bobkim938/auto-levelling-platform/README.md

# auto-levelling-platform using low cost IMU
