bobkim938/auto-levelling-platform/CAD/motor/FS5106R/Stiker.png

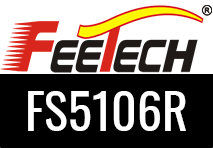
CAD/motor/FS5106R/Stiker.png
