bobkim938/auto-levelling-platform/CAD/Small Assem.SLDASM

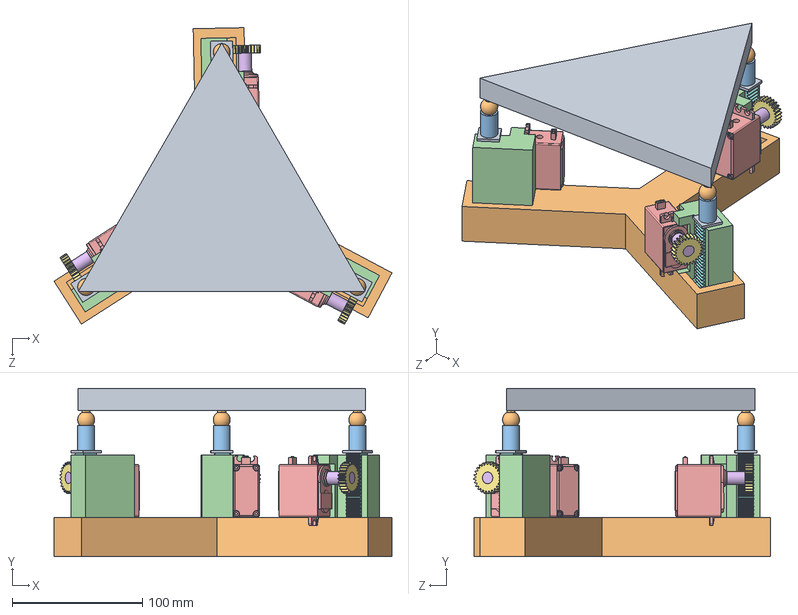
[picture p46: CAD file, 2023-07-06]
CAD/Small Assem.SLDASM
259.1 x 128.9 x 227.4 mm
END_EFFECTOR_Smaller
Linear guideFINAL x 3
FS5106R x 3
Motor_acc2 x 3
spur gear_iso x 3
rack spur rectangular_iso x 3
Top x 3
Base_small
