bobkim938/auto-levelling-platform/CAD/Actuator/2/Assem2.SLDASM

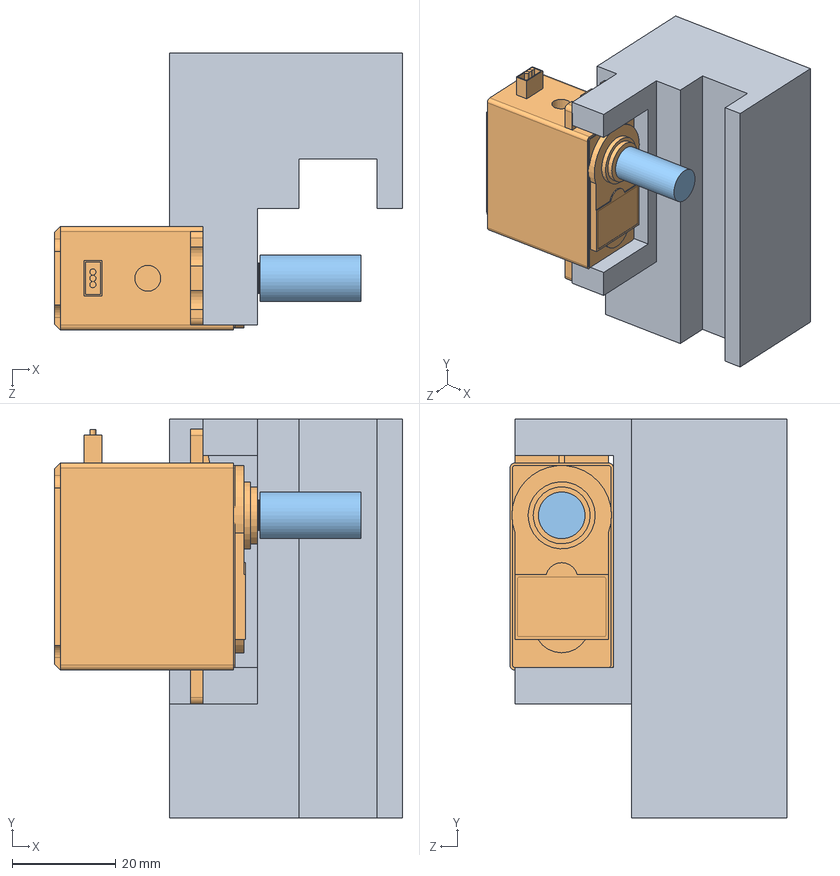
[picture p47: CAD file, 2023-07-06]
CAD/Actuator/2/Assem2.SLDASM
67.2 x 77.0 x 53.5 mm
Linear guide 2
FS5106R
Motor_acc2
