bobkim938/auto-levelling-platform/CAD/Spherical Joint/Ball and Socket Joint.SLDASM

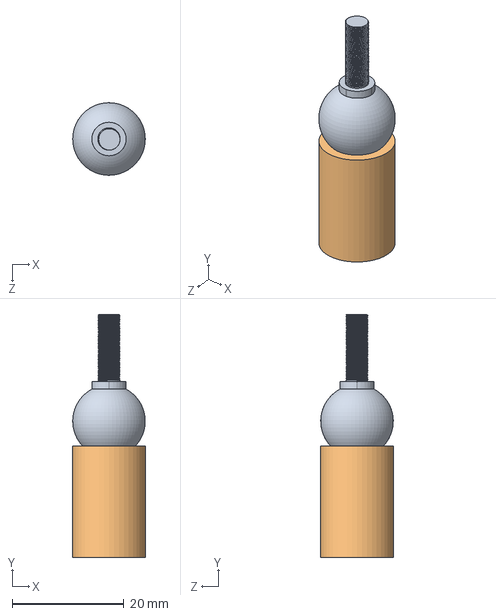
[picture p48: CAD file, 2023-07-06]
CAD/Spherical Joint/Ball and Socket Joint.SLDASM
13.0 x 43.5 x 13.0 mm
