bobkim938/auto-levelling-platform/CAD/Actuator/2/FinalAssembly.SLDASM

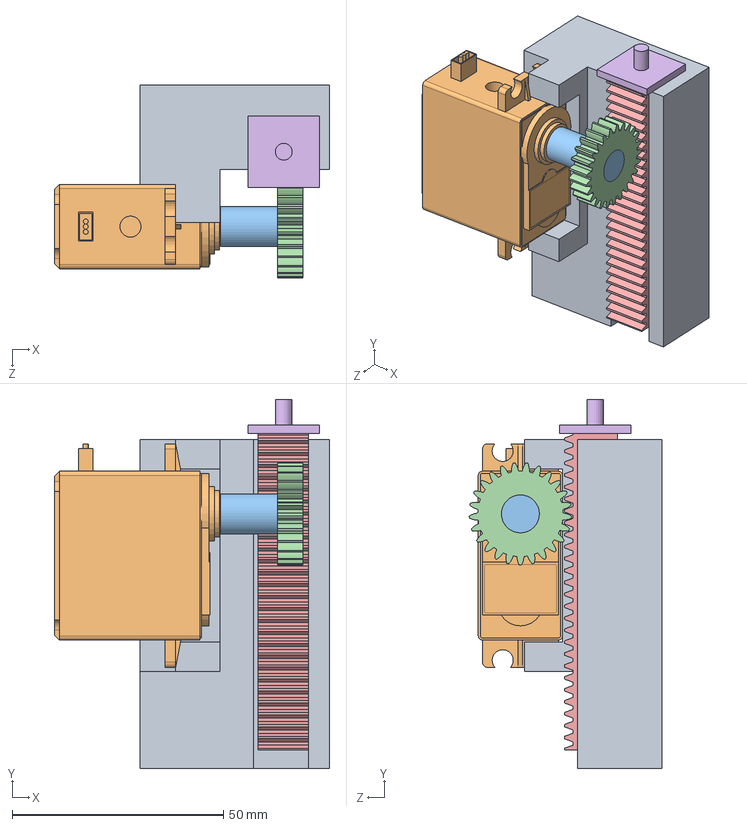
[picture p49: CAD file, 2023-07-06]
CAD/Actuator/2/FinalAssembly.SLDASM
65.2 x 87.4 x 45.6 mm
Linear guideFINAL
FS5106R
Motor_acc2
spur gear_iso
rack spur rectangular_iso
Top
