bobkim938/auto-levelling-platform/CAD/Actuator/2/Bottom.SLDPRT

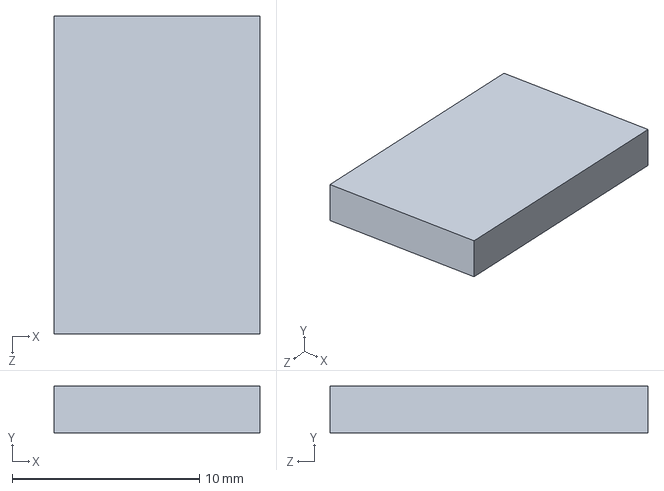
[picture p50: CAD file, 2023-07-06]
CAD/Actuator/2/Bottom.SLDPRT
11.0 x 2.50 x 17.0 mm
