bobkim938/auto-levelling-platform/CAD/Actuator/stl/2/Linear guideFINAL.SLDPRT

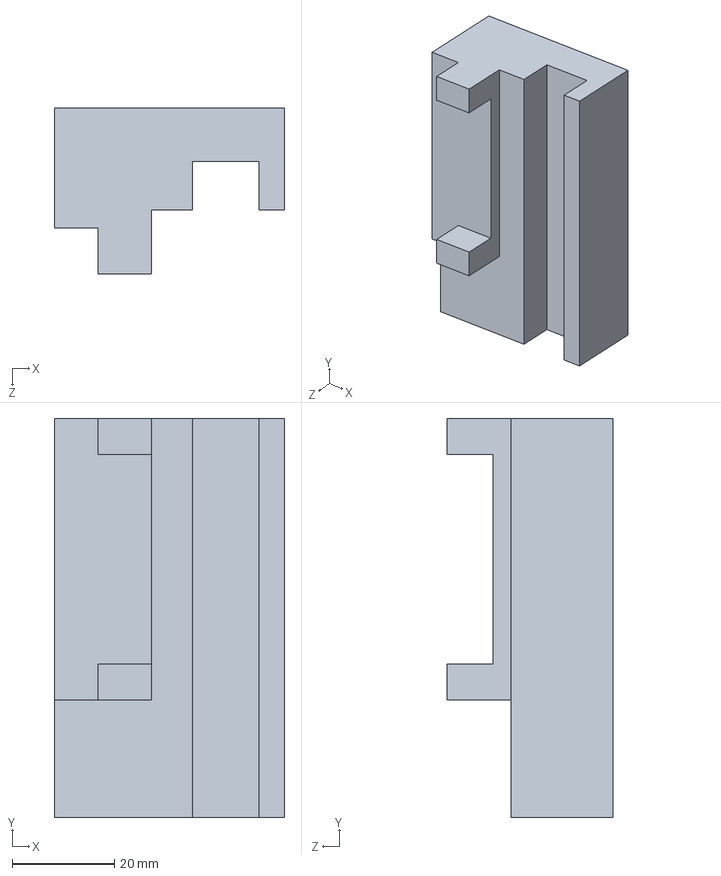
[picture p51: CAD file, 2023-07-06]
CAD/Actuator/stl/2/Linear guideFINAL.SLDPRT
45.0 x 78.0 x 32.5 mm
