bobkim938/auto-levelling-platform/CAD/Actuator/stl/Pinion Gear.STL

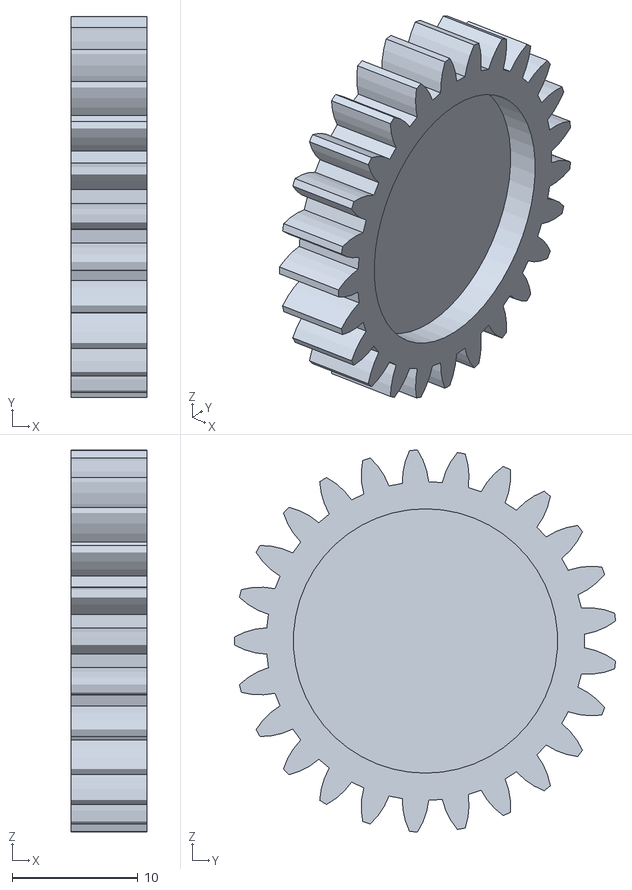
[picture p52: CAD file, 2023-07-06]
CAD/Actuator/stl/Pinion Gear.STL
6.00 x 30.3 x 30.3
