bobkim938/auto-levelling-platform/CAD/End effector and Base plate/Base_small.SLDPRT

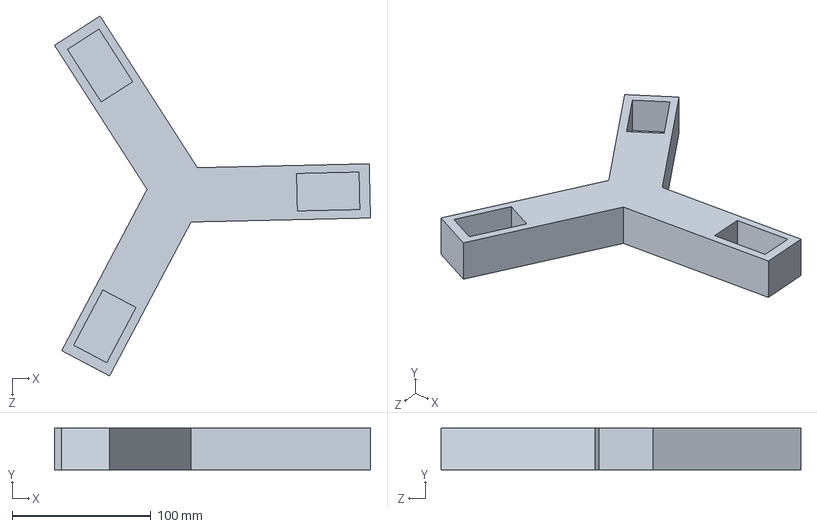
[picture p53: CAD file, 2023-07-06]
CAD/End effector and Base plate/Base_small.SLDPRT
227.4 x 30.0 x 259.1 mm
