bobkim938/auto-levelling-platform/CAD/motor/FS5106R.STEP

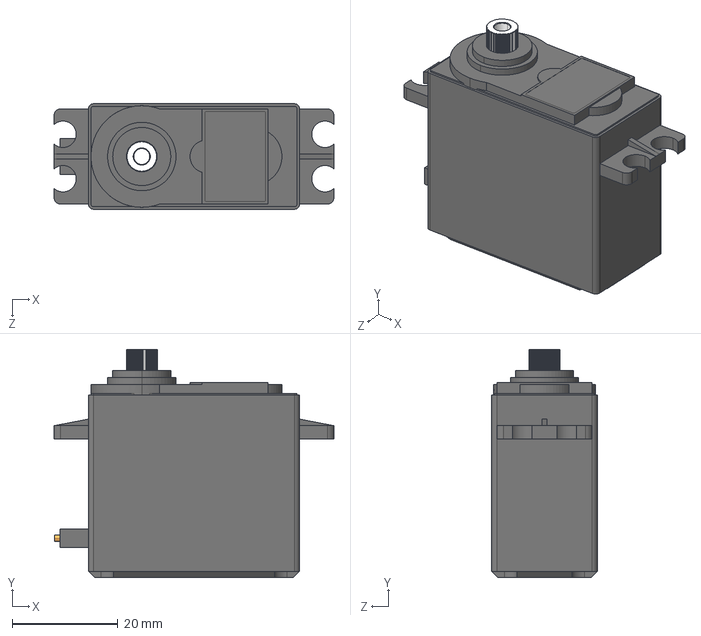
[picture p54: CAD file, 2023-07-06]
CAD/motor/FS5106R.STEP
53.0 x 43.2 x 20.0 mm
