bobkim938/auto-levelling-platform/CAD/Spherical Joint/Part2.SLDPRT

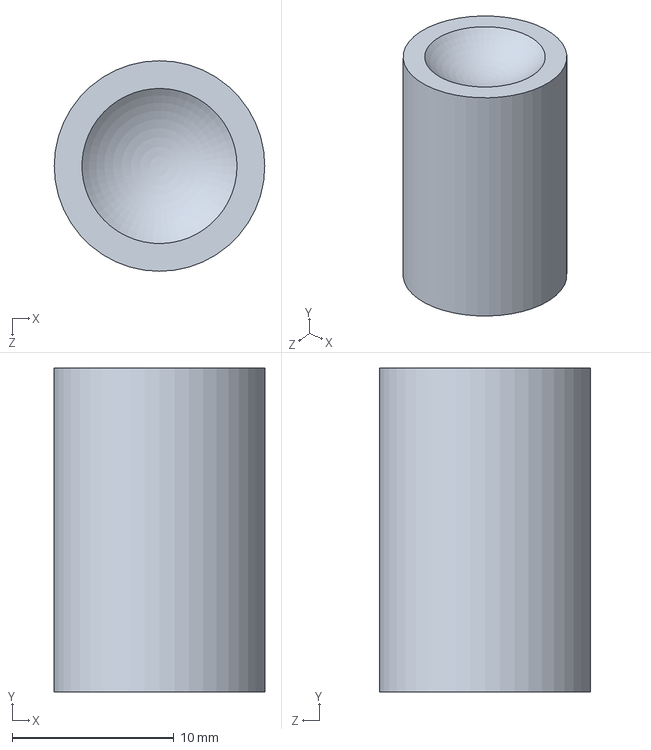
[picture p55: CAD file, 2023-07-06]
CAD/Spherical Joint/Part2.SLDPRT
13.0 x 20.0 x 13.0 mm
