bobkim938/auto-levelling-platform/CAD/Actuator/stl/Linear guide.STL

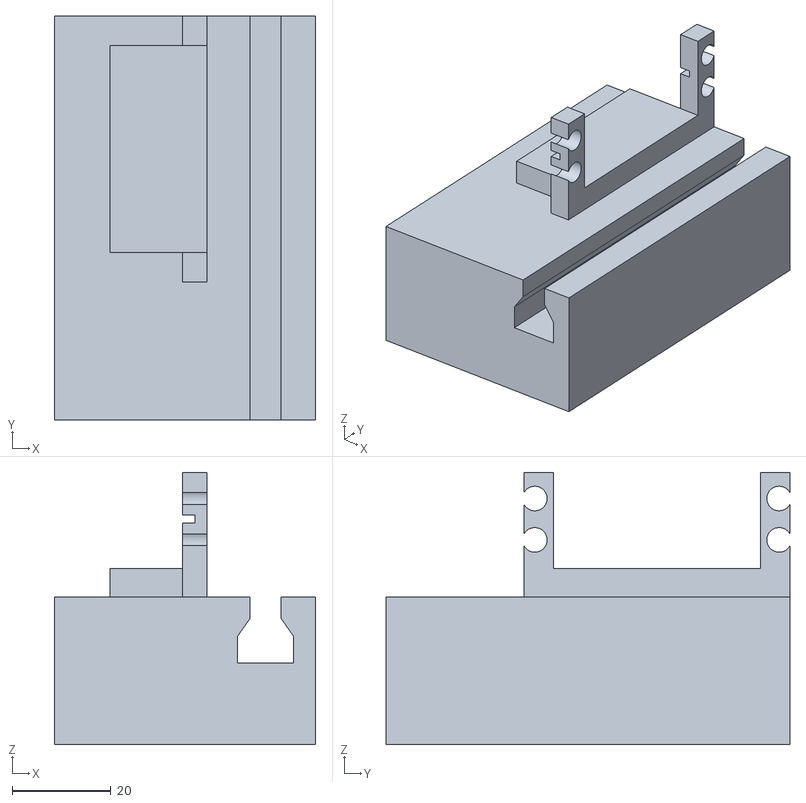
[picture p56: CAD file, 2023-07-06]
CAD/Actuator/stl/Linear guide.STL
53.0 x 82.0 x 55.2
