bobkim938/auto-levelling-platform/CAD/End effector and Base plate/END_EFFECTOR_Smaller.SLDPRT

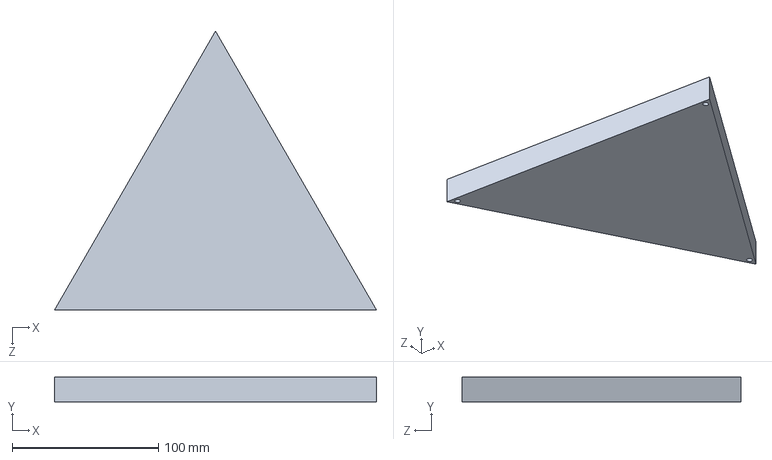
[picture p57: CAD file, 2023-07-06]
CAD/End effector and Base plate/END_EFFECTOR_Smaller.SLDPRT
220.0 x 17.0 x 190.5 mm
