bobkim938/auto-levelling-platform/CAD/Spherical Joint/Part1.SLDPRT

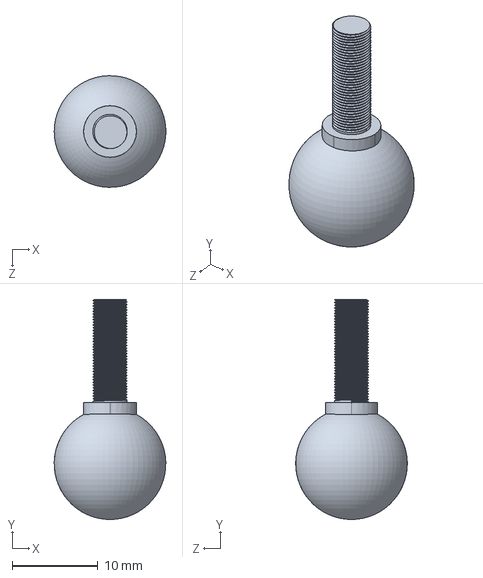
[picture p58: CAD file, 2023-07-06]
CAD/Spherical Joint/Part1.SLDPRT
13.0 x 25.6 x 13.0 mm
