bobkim938/auto-levelling-platform/CAD/Actuator/2/Motor_acc2.SLDPRT

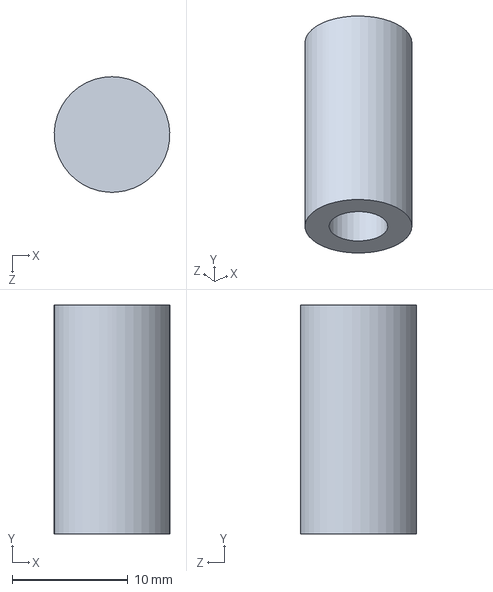
[picture p59: CAD file, 2023-07-06]
CAD/Actuator/2/Motor_acc2.SLDPRT
9.99 x 19.8 x 10.0 mm
