bobkim938/auto-levelling-platform/CAD/Actuator/stl/Rack.STL

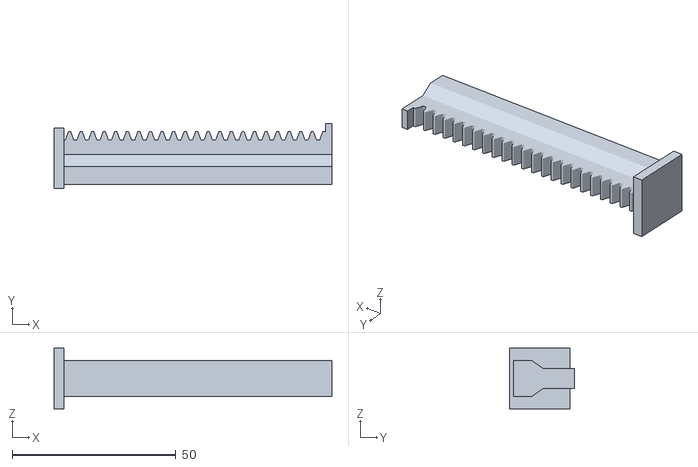
[picture p60: CAD file, 2023-07-06]
CAD/Actuator/stl/Rack.STL
85.0 x 20.0 x 18.5
