bobkim938/auto-levelling-platform/CAD/Actuator/2/Top.SLDPRT

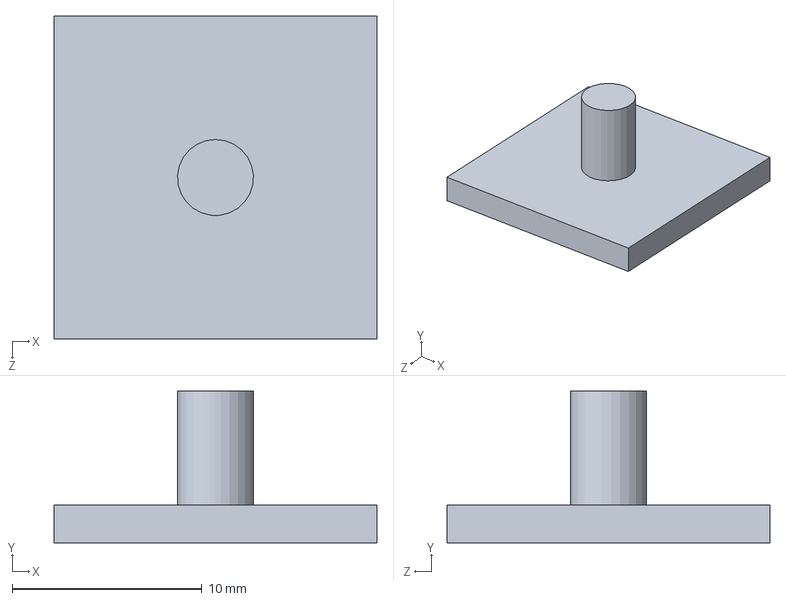
[picture p61: CAD file, 2023-07-06]
CAD/Actuator/2/Top.SLDPRT
17.0 x 8.00 x 17.0 mm
