bobkim938/auto-levelling-platform/CAD/Actuator/stl/Linear guide 2.STL

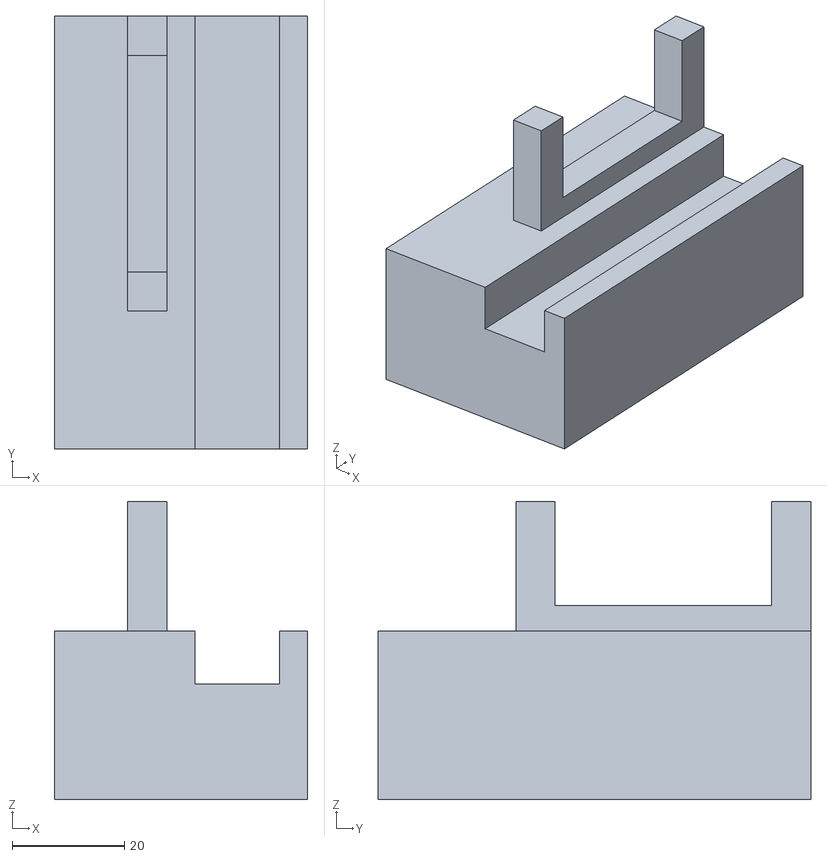
[picture p62: CAD file, 2023-07-06]
CAD/Actuator/stl/Linear guide 2.STL
45.0 x 77.0 x 53.0
