bobkim938/auto-levelling-platform/CAD/Actuator/2/Linear guide 2.SLDPRT

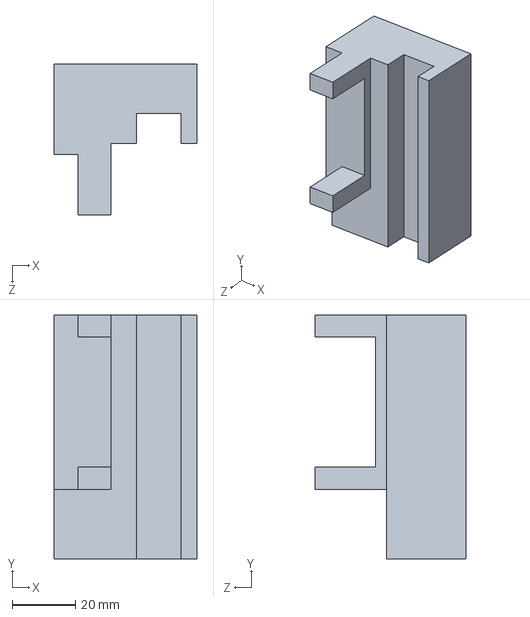
[picture p63: CAD file, 2023-07-06]
CAD/Actuator/2/Linear guide 2.SLDPRT
45.0 x 77.0 x 47.5 mm
