bobkim938/auto-levelling-platform/(list of files, cad)

Other CAD files:
CAD/Assembly.SLDPRT
CAD/motor/FS5106R/FS5106R.SLDPRT
CAD/Actuator/stl/Linear guide1.STL
CAD/Actuator/stl/2/Linear guideFINAL.STL
CAD/Actuator/stl/2/Motor_acc2.STL
CAD/Actuator/stl/2/Top.STL
