bobkim938/auto-levelling-platform/(commit log)

2023-03-28 add Kalman Filter for IMU
2023-03-28 Add Calibration for IMU
2023-07-06 Auto-Levelling Platform
    [Assem2.SLDASM, Assembly.SLDPRT, Ball and Socket Joint.SLDASM, Base_small.SLDPRT, Bottom.SLDPRT, END_EFFECTOR_Smaller.SLDPRT, FS5106R.SLDPRT, FS5106R.STEP]
